Ghostkeeper/Stormcrest/README.md

Stormcrest
==========

This project is an attempt at a pinball machine I'm building in order to enhance my understanding of electrical engineering and firmware programming.
