Ghostkeeper/Stormcrest/models/global_preferences.scad

color_electronics = [1, 0, 0];
color_hardware = [0, 0, 1];
color_wood = [0.8, 0.6, 0.2];

flipper_rotation_angle = 45; //Degrees rotation when activated.
