Ghostkeeper/Stormcrest/models/plunger_cap.scad

//Cap on top of the plunger rod.
//This has 4 functions:
//* Dampen the force on the ball to not scratch or dent it.
//* Transfer force from the spring towards the rod.
//* Stop the plunger from shooting along the launching lane.
//* Align the plunger towards the centre.

include <physical_dimensions.scad>

module plunger_cap() {
	shaft_length = plunger_rod_length - cabinet_thickness - plunger_handle_overlap - plunger_spring_length - plunger_cap_cone_length;

	difference() {
		union() {
			sphere(r=plunger_cap_radius);
			rotate([90, 0, 0]) {
				cylinder(r1=plunger_cap_radius, r2=ball_radius, h=plunger_cap_cone_length);
			}
			translate([0, -plunger_cap_cone_length, 0]) {
				rotate([90, 0, 0]) {
					cylinder(r=ball_radius, h=shaft_length);
				}
			}
		}
		rotate([90, 0, 0]) {
			cylinder(r=plunger_rod_radius, h=plunger_cap_cone_length + shaft_length);
		}

		//Holes to screw in threaded pins to clamp against the rod.
		translate([0, -plunger_cap_cone_length - shaft_length / 2, 0]) {
			cylinder(r=m4_bolt_radius, h=ball_radius);
			rotate([0, 90, 0]) {
				cylinder(r=m4_bolt_radius, h=ball_radius);
			}
			rotate([0, 180, 0]) {
				cylinder(r=m4_bolt_radius, h=ball_radius);
			}
			rotate([0, 270, 0]) {
				cylinder(r=m4_bolt_radius, h=ball_radius);
			}
		}
		//Diagonal threaded pins.
		translate([0, -plunger_cap_cone_length, 0]) {
			rotate([-45, 45, 0]) {
				cylinder(r=m4_bolt_radius, h=ball_radius);
			}
			rotate([-45, 225, 0]) {
				cylinder(r=m4_bolt_radius, h=ball_radius);
			}
		}
	}
}

/*
This cap must be printed dual-extrusion with the top bulb
printed in a flexible filament but the bottom being printed
in a hard filament. This rendering will create both models
separately for easy printing.
*/
module _plunger_cap_spiral() {
	translate([-plunger_cap_radius, 0, -plunger_cap_radius]) {
		cube([plunger_cap_radius * 2, plunger_cap_radius, plunger_cap_radius * 2]);
	}
	rotate([90, 0, 0]) {
		linear_extrude(height=plunger_cap_cone_length / 2, twist=360 * 2) {
			square(ball_radius);
			//The -0.001 prevents an edge case bug in CGAL with an assertion failure.
			translate([-ball_radius - 0.001, -ball_radius, 0]) {
				square(ball_radius);
			}
		}
	}
}
//Flexible print.
intersection() {
	plunger_cap();
	_plunger_cap_spiral();
}
//Hard print.
difference() {
	plunger_cap();
	_plunger_cap_spiral();
}
