Ghostkeeper/Stormcrest/instructions/index.md

Instructions
============
Building this pinball machine is a massive project. In these documents the steps to building it are fully detailed, as far as I've completed them.

1. [Building the cabinet](cabinet.md)
