Ghostkeeper/Stormcrest/firmware/display/waves.h

static uint8_t sprite_waves_0[][7][4] = {{{16, 17, 2, 0}, {8, 8, 0, 0}, {0, 64, 0, 0}, {0, 64, 0, 0}, {0, 130, 0, 0}, {16, 0, 0, 0}, {0, 44, 0, 0}, }, {{0, 0, 0, 0}, {36, 4, 1, 0}, {8, 0, 2, 0}, {0, 168, 0, 0}, {0, 0, 0, 0}, {0, 2, 0, 0}, {16, 68, 0, 0}, }, {{0, 96, 2, 0}, {32, 16, 0, 0}, {32, 0, 0, 0}, {16, 4, 0, 0}, {0, 192, 0, 0}, {0, 34, 0, 0}, {16, 8, 0, 0}, }, {{0, 32, 0, 0}, {24, 64, 1, 0}, {0, 0, 0, 0}, {16, 14, 2, 0}, {0, 128, 0, 0}, {0, 4, 0, 0}, {32, 64, 0, 0}, }, {{8, 128, 2, 0}, {16, 0, 0, 0}, {0, 84, 0, 0}, {0, 192, 0, 0}, {0, 8, 4, 0}, {16, 0, 0, 0}, {0, 32, 0, 0}, }, {{8, 0, 0, 0}, {0, 8, 2, 0}, {0, 32, 0, 0}, {32, 128, 0, 0}, {0, 10, 1, 0}, {16, 4, 0, 0}, {16, 64, 0, 0}, }, {{16, 96, 0, 0}, {8, 0, 0, 0}, {0, 144, 4, 0}, {0, 12, 1, 0}, {0, 64, 0, 0}, {16, 40, 0, 0}, {0, 0, 2, 0}, }, {{32, 2, 1, 0}, {32, 8, 4, 0}, {16, 16, 0, 0}, {0, 0, 0, 0}, {0, 132, 2, 0}, {0, 120, 0, 0}, {0, 0, 0, 0}, }, };
static uint8_t sprite_waves_1[][7][3] = {{{0, 130, 0}, {8, 0, 0}, {16, 0, 0}, {64, 0, 0}, {8, 0, 0}, {132, 0, 0}, {32, 64, 0}, }, {{16, 2, 0}, {32, 0, 0}, {32, 0, 0}, {8, 128, 0}, {0, 0, 0}, {0, 64, 0}, {196, 0, 0}, }, {{0, 128, 0}, {12, 16, 0}, {128, 2, 0}, {0, 0, 0}, {8, 64, 0}, {68, 0, 0}, {0, 0, 0}, }, {{32, 2, 0}, {0, 0, 0}, {0, 0, 0}, {8, 64, 0}, {0, 0, 0}, {4, 128, 0}, {192, 0, 0}, }, {{0, 0, 0}, {4, 128, 0}, {40, 0, 0}, {128, 0, 0}, {64, 1, 0}, {1, 0, 0}, {0, 0, 0}, }, {{24, 64, 0}, {0, 0, 0}, {136, 0, 0}, {32, 2, 0}, {0, 0, 0}, {4, 128, 0}, {0, 0, 0}, }, {{48, 1, 0}, {8, 0, 0}, {0, 0, 0}, {0, 2, 0}, {128, 0, 0}, {4, 0, 0}, {64, 128, 0}, }, {{32, 64, 0}, {32, 0, 0}, {8, 0, 0}, {128, 0, 0}, {4, 0, 0}, {1, 0, 0}, {64, 128, 0}, }, };
static uint8_t sprite_waves_2[][7][1] = {{{1}, {0}, {40}, {2}, {0}, {0}, {4}, }, {{0}, {0}, {9}, {0}, {64}, {4}, {2}, }, {{0}, {40}, {0}, {1}, {4}, {0}, {2}, }, {{1}, {0}, {104}, {0}, {0}, {6}, {0}, }, {{18}, {5}, {8}, {0}, {32}, {64}, {0}, }, {{8}, {0}, {67}, {32}, {0}, {0}, {4}, }, {{26}, {1}, {4}, {64}, {0}, {32}, {0}, }, {{0}, {0}, {8}, {64}, {0}, {0}, {6}, }, };
static uint8_t sprite_waves_3[][7][1] = {{{128}, {0}, {0}, {96}, {0}, {0}, {0}, }, {{16}, {0}, {128}, {64}, {0}, {32}, {0}, }, {{128}, {0}, {0}, {64}, {32}, {0}, {0}, }, {{0}, {0}, {128}, {96}, {0}, {0}, {0}, }, {{16}, {128}, {96}, {0}, {0}, {0}, {0}, }, {{0}, {128}, {16}, {0}, {0}, {96}, {0}, }, {{16}, {128}, {0}, {0}, {96}, {0}, {0}, }, {{0}, {0}, {128}, {112}, {0}, {0}, {0}, }, };
