Ghostkeeper/Stormcrest/(commit log)

2019-01-05 Add basic design for flipper
    Also leaving some room for a hex key in the future.
    [flipper.scad]
2019-01-05 Allow slot to insert hex key
    The key is intended to make the transfer of force from the solenoid to the flipper very strong. Basically steel reinforcement inside the flipper, as well as a steel shaft to rotate around.
    I hope that the hex key is oriented correctly at the top.
    [flipper.scad]
2019-01-05 Rename body to fipper
    Let's do the crank shaft in a different file.
    [flipper.scad]
2019-01-05 Make flipper smaller
    This makes it more realistic in comparison to common flippers.
    [flipper.scad]
2019-01-05 Add play to flipper insert
    The hex key has to fit in there and that one won't budge a bit with its diameter, whatever our printing process will be.
    [flipper.scad]
2019-01-05 Reduce height of flipper
    It should not be exactly as tall as the ball, but slightly smaller, I think.
    [flipper.scad]
2019-01-05 Add assertions for custom settings
    Because I'm currently using an old build that doesn't support this yet, I need to comment them out. For now they serve just as documentation.
    [flipper.scad]
2019-01-05 Make corner between sides of hexkey nicer
    In actuality it's a round corner, but the radius of that corner is unknown and for now unnecessary.
    [flipper.scad]
2019-01-06 Add basis cylinder for flipper grip
    This grip is supposed to transfer force from the solenoids to the flipper on the underside of the board.
    [flipper_grip.scad]
2019-01-06 Model the solenoid
    It will not be printed but it should get modelled in the design.
    [flipper_grip.scad]
2019-01-06 Model the hole in the solenoid pin
    [flipper_grip.scad]
2019-01-06 Model rotation around pinhole in solenoid
    [flipper_grip.scad]
2019-01-06 Fix rotation point of solenoid grip
    It's going to rotate around the pinhole in the pin.
    [flipper_grip.scad]
2019-01-06 Sink a nut on the other end
    I suppose we'll have to find a bolt that's just the correct length. Later worries. Otherwise the nut sink can be adjusted accordingly.
    [flipper_grip.scad]
2019-01-06 Use smaller hex key
    Otherwise the hex key would hit the solenoid, because the small expansion length of the solenoid requires it to be very close to the rotational axis in order to rotate the flipper enough.
    [flipper.scad, flipper_grip.scad]
2019-01-06 Some documentation
    [flipper_grip.scad]
2019-01-06 Move physically bound settings to separate file
    This way we can keep them the same over the entire span of the project, without having to update multiple files.
    [flipper.scad, flipper_grip.scad, physical_dimensions.scad]
2019-01-06 Add play to flipper grip
    Both play that is needed for inaccuracy in printing and play to allow for movement freedom.
    [flipper_grip.scad, physical_dimensions.scad]
2019-01-06 Add grip to attach spring
    This needs to pull the flipper back in position when lowering it.
    [flipper_grip.scad]
2019-01-06 Leave hole for spring bolt
    Hopefully we can find a bolt that is short enough to not puncture or scrape the play field. Should be 15mm.
    [flipper_grip.scad]
2019-01-07 Leave space for nut around spring bolt
    This nut needs to be inside the model because the model attaches to the playfield from the underside.
    [flipper_grip.scad, physical_dimensions.scad]
2019-01-07 Remove assertions only by checking OpenSCAD version
    So that it's automatically enabled if you are using a more modern version.
    [flipper.scad, flipper_grip.scad]
2019-01-07 Some corrections to solenoid dimensions
    According to the schematics.
    [physical_dimensions.scad]
2019-01-07 Separate model for flipper's solenoid
    This way we can use it to create space for this model in our flipper grip.
    [flipper_solenoid.scad]
2019-01-07 New dimensions for screws in solenoid
    [physical_dimensions.scad]
2019-01-07 Redesign attachment of solenoid to grip
    Since the pin is going to rotate around the axis, but the solenoid is not, the pinhole needs to be a line rather than a single slot.
    [flipper_grip.scad, flipper_solenoid.scad]
2019-01-07 Simplify rendering of solenoid pin hole
    Just render the single cylinder for the pin. This also fixes the bolt that goes through the pin if the rendering resolution is not equal everywhere.
    [flipper_grip.scad]
2019-01-07 Remove superfluous bolt hole
    It's no longer used. Also correct play on the new holes.
    [flipper_grip.scad]
2019-01-07 Make punched corner extra thick
    It's going to take some force, and previously it was a bit slim because the pin expansion would make the punch location shift left.
    [flipper_grip.scad]
2019-01-07 Rename play to printing_play
    To be more specific and more clear.
    [flipper.scad, flipper_grip.scad, physical_dimensions.scad]
2019-01-07 Make spring end printable
    With a 50 degree overhang angle. Looks good.
    [flipper_grip.scad, physical_dimensions.scad]
2019-01-08 Move spring arm to separate module
    This way we can reuse it.
    [flipper_grip.scad]
2019-01-08 Replace solenoid side with similar attachment as spring
    I realised that the sliding-pin technique was too complex for what it needed to do and would introduce much more friction than necessary. Instead, the assembly will now require an additional part: A linear bar to transfer force from the solenoid to the grip. But this allows it to rotate the attachment between that bar and the grip around just a single point instead of having a sliding pin sort of construction.
    [flipper_grip.scad]
2019-01-08 Rotate spring arm instead of solenoid arm
    The solenoid arm is the 'main' one in my mind. Also, this makes the arm module a bit easier with the signs.
    [flipper_grip.scad]
2019-01-08 Allow movement of attaching piece between solenoid and grip
    It must be able to still be attached while not hitting the grip, while the solenoid is extended and thus the grip is rotated by 45 degrees.
    [flipper_grip.scad, physical_dimensions.scad]
2019-01-08 Fix apparent rounding error in CGAL
    CGAL was producing a plane there at the bottom side of the previous location of this cube that the diagonal cube intersects with. The plane had 0 thickness but it did show up in the final render.
    Moving the plane down by the spacing fixes that.
    [flipper_grip.scad]
2019-01-08 Add 'pin gap'
    This is what I call the horizontal slot through the pin in the solenoid. Its dimensions are known.
    [flipper_solenoid.scad, physical_dimensions.scad]
2019-01-08 Remove debugging resolution setting
    The overall resolution should be set in the assembly file.
    [flipper_solenoid.scad]
2019-01-08 Fix printing play at motion freedom cutout
    [flipper_grip.scad]
2019-01-08 Model the brace between solenoid and grip
    Now to hopefully position it all correctly...
    [flipper_solenoid_brace.scad]
2019-01-10 Add model of hex key
    So we can show it in our assembly.
    [hexkey.scad, physical_dimensions.scad]
2019-01-10 Rename flipper to flipper_bat
    This way we can store the flipper assembly as just flipper.
    [flipper_bat.scad, physical_dimensions.scad]
2019-01-10 Add assembly for flipper
    [flipper.scad, physical_dimensions.scad]
2019-01-10 Color-code hardware and electronics
    The rest, for now, is 3D printed.
    [flipper_solenoid.scad, global_preferences.scad, hexkey.scad]
2019-01-10 Add model of a spring
    [spring.scad]
2019-01-10 Add spring to assembly
    [flipper.scad]
2019-01-14 Fix required rotation axis of flipper
    This rotation axis calculation only works if the solenoid emits a force at exactly half of the rotation that the flipper moves in.
    [flipper.scad, flipper_grip.scad, global_preferences.scad]
2019-01-16 Fix model not rendering due to overflow
    Apparently that number is too high for CGAL.
    [flipper_grip.scad]
2019-01-16 Sort and categorise dimensions better
    It's alphabetical rather than arbitrary order.
    [physical_dimensions.scad]
2019-01-16 Reorder to fix dependency between measurements
    [physical_dimensions.scad]
2019-01-17 Add basic cabinet
    Probably not final measurements. It's a bit rough now.
    [cabinet.scad]
2019-01-20 Adjust cabinet to wood dimensions
    These are the dimensions of the base plate I bought.
    [cabinet.scad]
2019-01-21 Add slit to make the ball fall through
    If you lost the ball, here's where it goes.
    [cabinet.scad]
2019-01-22 Put cabinet in a module
    This way we can use the file without immediately rendering it.
    [cabinet.scad]
2019-01-22 Echo instructions for cutting the wood
    Shouldn't be all too hard now.
    [cabinet.scad]
2019-01-29 Include thickness of wood in lengthwise planks
    Rather than in the crosswise planks.
    [cabinet.scad]
2019-01-29 Add back panel with space for LED matrix
    [cabinet.scad, physical_dimensions.scad]
2019-02-02 Move cabinet dimensions into physical_dimensions
    That way we can use them for other parts. Basically the whole project will need this.
    [cabinet.scad, physical_dimensions.scad]
2019-02-02 Add assembly file of the complete cabinet
    Or at least what's been designed so far.
    [assembly.scad]
2019-02-02 Correct placement of playfield items
    The same transformations as in the cabinet file.
    [assembly.scad]
2019-02-02 Correct playfield thickness
    The board is 18mm multiplex wood. Pretty strong...
    [physical_dimensions.scad]
2019-02-17 Add bill of materials
    These are the supplies that I've used so far that are reasonably fixed. I'm pretty sure I'm going to need these.
2019-02-17 Add easy configuration header
    This creates a display for us with the correct pins and the correct scan rate, and starts it.
    The code compiles, but is untested since we don't display anything yet.
    [display.ino, px_matrix_config.h]
2019-02-19 Add Python script to pack wave sprite data into source
    This converts the sprite into C source code that can be included to have the pixel data in a variable.
    This is necessary because this device will not have any flash drive or file system or anything. So you can't load this data from file, so it has to be included statically in the source code.
2019-03-01 Simplify formulas with intermediary calculations
    Makes this a bit easier to read.
    [cabinet.scad]
2019-03-01 Fix z-fighting in OpenSCAD's preview mode
    I'm going to be using the preview of the assembly a lot, and then it's annoying when there's that z-fighting in the way.
    [cabinet.scad]
2019-03-01 Make back of cabinet higher
    This is necessary to fit some higher elements in the back. This may be a bit too much though, going by the width of my wooden planks.
    [cabinet.scad, physical_dimensions.scad]
2019-03-01 Print side height as well
    That's important to make this fit using the two wooden planks I have available.
    [cabinet.scad]
2019-03-01 Take bottom off due to planks limitation
    My planks are only so wide. If I make this higher then I'd have to add another piece of wood in this corner, which I don't want to do.
    [cabinet.scad, physical_dimensions.scad]
2019-03-01 Make wooden pieces brown
    This is to make it recognisable how to assemble the machine.
    [cabinet.scad, global_preferences.scad]
2019-03-01 Add model for ordinary solenoid
    Currently these have the same dimensions as the flipper solenoid (so I just copied the code) but half the voltage.
    [physical_dimensions.scad, solenoid.scad]
2019-03-01 Add design for plunger
    This is a metal rod with a spring. The rod is attached to a handle (with glue? screws?) and hanging loose on the other side. The ball rolls into the cavity at the loose end of the rod. The user can pull on the handle, compressing the spring, and then let go at some point, launching the rod forward just beyond the gate, slamming against the ball and thus launching the ball into the playfield.
    [physical_dimensions.scad, plunger.scad]
2019-03-02 Add stop to compress spring
    This stop is attached to the rod with screws. Hopefully you can screw those in to have enough friction on the rod to hold the stop in place in order to compress the spring.
    [plunger.scad]
2019-03-02 Separate plunger spring out into separate module
    We need to separate everything out in order to be able to model them separately, generate them separately (for efficiency) and print them separately.
    [physical_dimensions.scad, plunger.scad, plunger_spring.scad]
2019-03-02 Separate plunger rod out into separate module
    This way we can leave it out when preparing to print stuff.
    [plunger.scad, plunger_rod.scad]
2019-03-02 Separate out plunger handle to separate module
    This way we can print them separately, and it'll be easier to compile things with accurate caches in the assembly.
    [plunger.scad, plunger_handle.scad]
2019-03-02 Separate out spring stop to separate module
    Also, re-use this module in order to make the cut-out in the gate block.
    [physical_dimensions.scad, plunger.scad, plunger_spring_stop.scad]
2019-03-02 Move plunger gate to separate module
    This way we can print it separately.
    [plunger.scad, plunger_gate.scad]
2019-03-02 Flip handle around
    The bottom was on the other side.
    [plunger.scad]
2019-03-03 Increase interrupt rate for less flickering
    We can take it.
2019-03-03 Redesign plunger cap
    This can do multiple things at once. It's a very important piece and elegantly designed. Quite happy with this design.
    [physical_dimensions.scad, plunger.scad, plunger_cap.scad, plunger_gate.scad, plunger_spring.scad, plunger_spring_stop.scad]
2019-03-03 Add holes for threaded pins to lock cap onto bolt
    I hope that this works when printed dual-extrusion.
    [physical_dimensions.scad, plunger_cap.scad]
2019-03-03 Split plunger cap into dual extrusion print
    This allows the tip to be soft but the bottom to be hard.
    The spiral thing is meant to interweave the two materials very strongly, since flexible and non-flexible materials tend to not adhere to each other very well and this thing takes quite a bit of force.
    [plunger_cap.scad]
2019-03-03 Fix ball rolling towards middle of launching gate
    [plunger_gate.scad]
2019-03-03 Add screw holes to attach the plunger gate
    The plunger is attached by these two screws and via a hole in the cabinet.
    [plunger_gate.scad]
2019-03-03 Make plunger into a re-usable module
    Oops, forgot about this.
    [plunger.scad]
2019-03-03 Add plunger to assembly
    This immediately reveals a flaw thar arose due to the incline of the playfield. Going to have to think about a solution here...
    [assembly.scad]
2019-03-03 Remove duplicate colour command
    [plunger.scad]
2019-03-03 Fix crooked plunger
    Otherwise we'd have to drill a hole through the cabinet at exactly 6 degrees. That won't work out well. This is now much easier to assemble and it makes more sense for the user in which direction he has to pull the plunger.
    [assembly.scad, plunger.scad, plunger_gate.scad]
2019-03-08 Add one half of the gutter
    I need to make it connect to the upper half somehow though, and to the lifting solenoid.
    [lower_gutter.scad, physical_dimensions.scad]
2019-03-10 Redesign gutter to print in one go
    It'll print faster this way. I hope it won't topple over.
    You're also going to need a bigger printer.
    [gutter.scad, lower_gutter.scad, physical_dimensions.scad]
2019-03-10 Add ledge to attach gutter to playfield
    This means that the gutter will be angled at an incline of 6 degrees. But that's okay. It won't affect the rolling of the ball much. In fact, it may even may it better because the layers will be staggered within the chamfer.
    [gutter.scad]
2019-03-10 Extract intermediate values
    Makes it a bit more readable.
    [gutter.scad]
2019-03-10 Add screwholes to attach gutter
    6 should be enough. And if not, it's a setting.
    [gutter.scad, physical_dimensions.scad]
2019-03-10 Stagger screw holes
    This will hopefully make the attachment a bit less wonky, as previously it could rotate around the axis that all the screws were attached to.
    [gutter.scad]
2019-03-10 Countersink nuts instead of bolt heads
    The nuts lock themselves then since they are hexagonal instead of round, so that makes a lot more sense.
    [gutter.scad, physical_dimensions.scad]
2019-03-10 Add alignment pin holes
    From the other side (the lift that brings the ball back up to the playfield) we'll have two screws that lock in here to align the lift to the gutter.
    [gutter.scad]
2019-03-10 Add third alignment screw to firmly affix lift to gutter
    Because in the other two places, the walls are a bit too thin to make a solid connection.
    [gutter.scad]
2019-03-16 Rename gutter_screw_hole module
    So that it doesn't clutter up the namespace.
    [gutter.scad]
2019-03-16 Add lift module to bring ball back up after gutter
    Not complete yet, since there is no way to attach it yet, no room for the solenoid, no lifting system, etc.
    [gutter_lift.scad]
2019-03-16 Don't shear pin holes
    Otherwise the pins wouldn't fit.
    [gutter.scad]
2019-03-16 Move pin holes now that they are no longer sheared
    Otherwise they'd pierce through the edge and that wouldn't be very strong.
    [gutter.scad]
2019-03-16 Add pinholes to attach to gutter
    [gutter_lift.scad]
2019-03-16 Fix glitching in preview render in OpenSCAD
    By adding a bit of overlap.
    [gutter_lift.scad]
2019-03-16 Add attachment to underside of playfield
    [gutter_lift.scad]
2019-03-16 Add screw hole to attach lift to playfield
    [gutter_lift.scad]
2019-03-16 Attach screw upside down
    Because we can't have the screw stick out at the top. That would be in the runway of the ball up top.
    [gutter_lift.scad, physical_dimensions.scad]
2019-03-17 Add channel at the top of the lift to guide the ball
    Make sure that the ball ends up in the launching bay.
    [gutter_lift.scad]
2019-03-17 Add lift to assembly
    And this reveals the big problem with the gutter: The two lane wall thicknesses won't fit behind the playfield because they add on to the ball slit.
    [assembly.scad]
2019-03-17 Add corner after lane towards launcher
    I hope that the solenoid will have enough power to make this corner every time.
    [gutter_lift.scad]
2019-03-17 Fix graphical glitches in OpenSCAD rendering
    [gutter_lift.scad]
2019-03-17 Create a hole in bottom of lift for kicker
    The kicker has a cup there that the ball can rest in. I hope this works; I may need to add some guidance rails for the cup.
    [gutter_lift.scad]
2019-03-17 Improve rendering performance by pre-rendering lift
    It takes longer to prepare the preview, but you'll get a much better framerate.
    [gutter_lift.scad]
2019-03-18 Add base of protractor tool
    This tool is used to measure several angles while constructing the machine.
    [protractor.scad]
2019-03-18 Add engravings to mark which angle is which
    [protractor.scad]
2019-03-18 Fix rendering in preview mode
    Makes it easier to see what I'm doing.
    [protractor.scad]
2019-03-18 Make axle hole and grooves for bar
    [protractor.scad]
2019-03-18 Add printing play to groove width
    Oops, forgot that here.
    [protractor.scad]
2019-03-18 Add bar design
    [protractor.scad]
2019-03-18 Add clamp to screw bar down upon the base
    Now to make some screw holes...
    [protractor.scad]
2019-03-18 Add screw holes
    Including sunken nut.
    [protractor.scad]
2019-03-18 Change some settings
    I want to be able to place it on 0. And making the base smaller gives us a bit more reach on the long side with our maximum printer size. Also, use an UMS5 to print the long bar.
    [protractor.scad]
2019-03-18 Allow placing the bar in the other direction too
    Just make the grooves a bit longer so that the bar can be long in the other direction just as well.
    [protractor.scad]
2019-03-23 Add materials for cabinet
2019-04-13 Divide cabinet up into planks
    Instead of one big box, it's now just separate planks next to each other.
    This will help to see how the cabinet is constructed.
    [cabinet.scad, physical_dimensions.scad]
2019-04-20 Fix rendering of front side in preview mode
    No Z fighting! Be quiet, Zs.
    [cabinet.scad]
2019-04-21 Cut off part that intersects with cabinet
    Otherwise moving the panel down causes it to bump against the front wall of the cabinet.
    [gutter_lift.scad]
2019-04-21 Add legs to cabinet
    Not sure yet about the positioning of the metal hook profiles that I obtained for strengthening the corners. I might have to put them up above the playfield then.
    [cabinet.scad, physical_dimensions.scad]
2019-04-22 Add a space and holder for push solenoid
    Another new type of solenoid. Hopefully I can change some of the other ones to also use this type of solenoid so that the BOM becomes somewhat simpler.
    [gutter_lift.scad, physical_dimensions.scad]
2019-04-22 Fix using cabinet thickness instead of playfield thickness
    You can now properly change the cabinet thickness and it'll all still fit, you see. Handy if you want to try and rebuild this yourself with slightly different dimensions.
    [cabinet.scad]
2019-04-26 Add printing play to thickness of playfield
    There is some sagging involved.
    [gutter_lift.scad]
2019-04-26 Remove print-level render settings
    Don't want those to enable by default. You need to be able to preview it.
    [gutter_lift.scad]
